DashRobotics/Dash-v1.0/Dash_App/Dash/iphone@2x.png

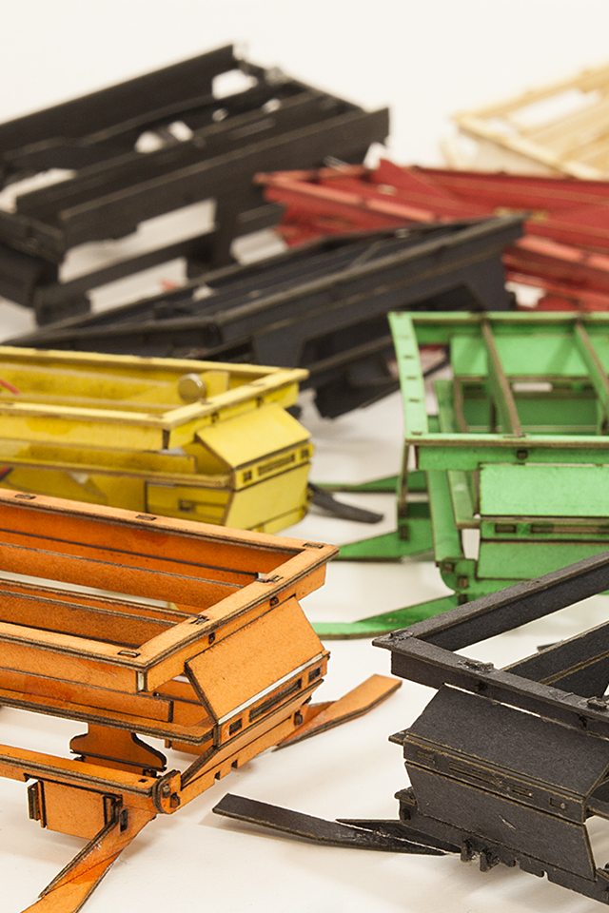
Dash_App/Dash/iphone@2x.png
