DashRobotics/Dash-v1.0/Dashboard-v1.0-hardware/README.md

Dashboard-v1.0
==============

Schematic and PCB files for the Dashboad v1.0

Repository Contents
==============

dashboard_v1_0_schematic.dsn : schematic file, use TinyCAD to read/edit

dashboard_v1_0_schematic.pdf : PDF copy of schematic file

dashboard_v1_0.fpc : PCB files. Use FreePCB to read/edit

/board_renders : .png images of the PCB layers

License Information
==============

The hardware is released under Creative Commons Share-alike 3.0.
