DashRobotics/Dash-v1.0/Examples/README.txt

This repository contains example code for Dash. These will require you to use the Arduino IDE and set up the Dash library.
