DashRobotics/Dash-v1.0/Dash_App/Dash/html/hands_nice_vimeo_small.jpg

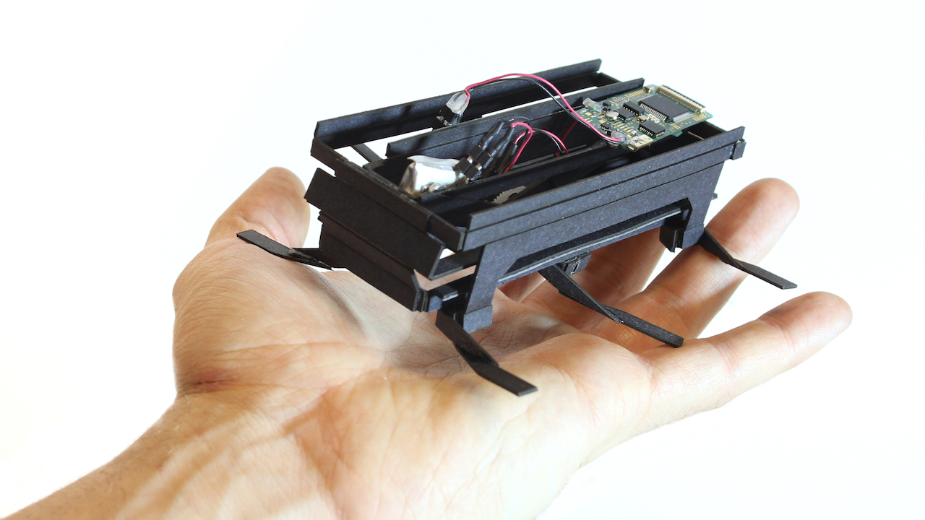
Dash_App/Dash/html/hands_nice_vimeo_small.jpg
