DashRobotics/Dash-v1.0/Dash_App/Dash/iphone-tall-blur@2x.png

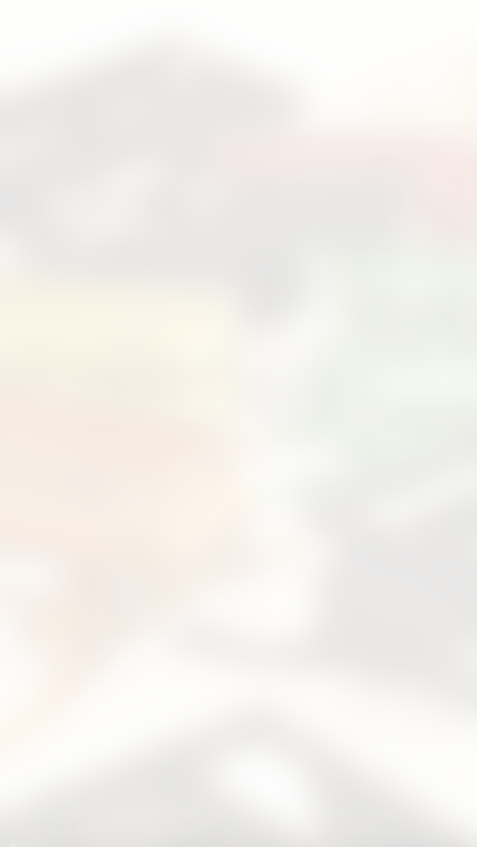
Dash_App/Dash/iphone-tall-blur@2x.png
