DashRobotics/Dash-v1.0/Dash_App/Dash/iphone-tall.png

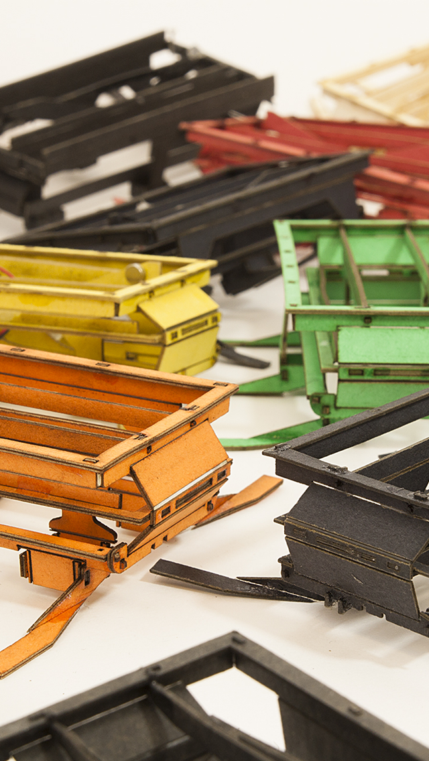
Dash_App/Dash/iphone-tall.png
