DashRobotics/Dash-v1.0/Dashboard-v1.0-hardware/board_renders/board_outline.png

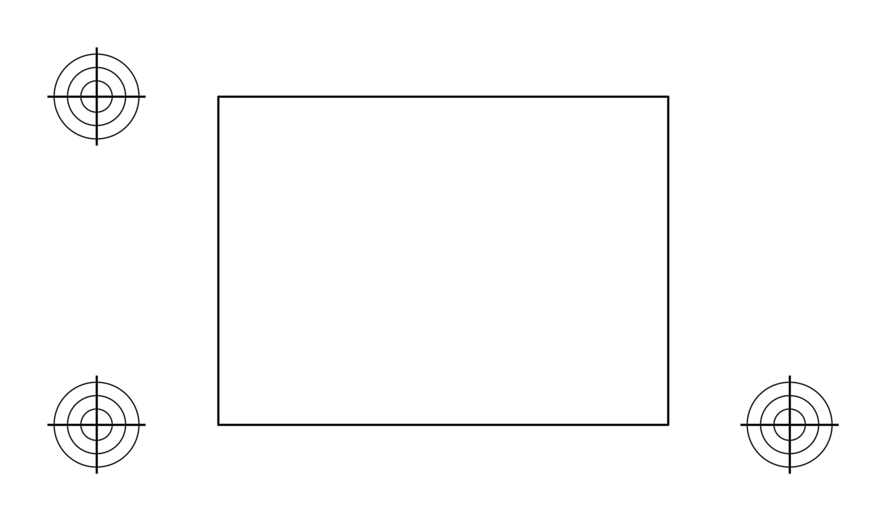
Dashboard-v1.0-hardware/board_renders/board_outline.png
