DashRobotics/Dash-v1.0/Dashboard-v1.0-hardware/board_renders/bottom_copper.png

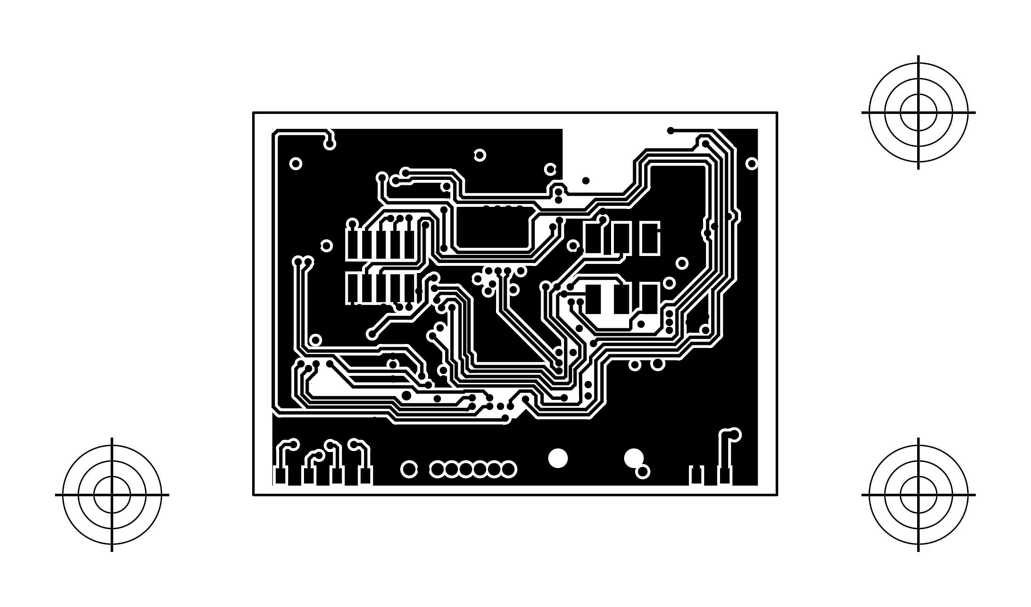
Dashboard-v1.0-hardware/board_renders/bottom_copper.png
