DashRobotics/Dash-v1.0/Dashboard-v1.0-hardware/board_renders/inner_copper_1.png

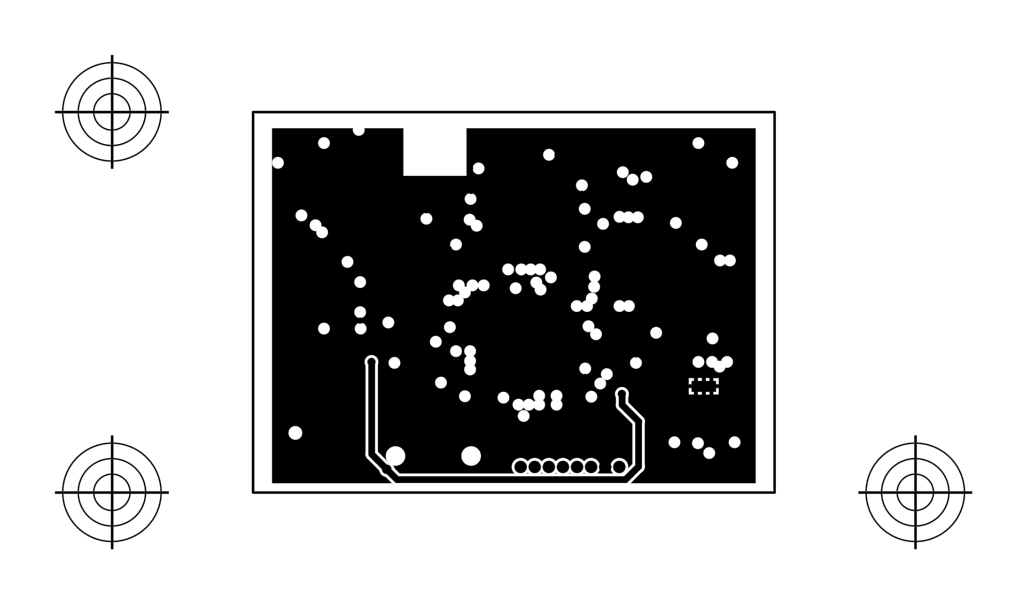
Dashboard-v1.0-hardware/board_renders/inner_copper_1.png
