DashRobotics/Dash-v1.0/Dash_App/Dash/instructions.pdf

## Build instructions

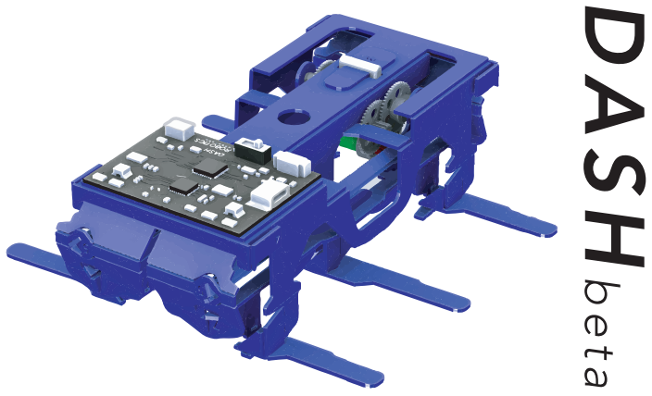
[picture p15: figure]

## Videos and Details at: www.dashrobotics.com, or visit www.forum.dashrobotics.com

Get ready to build your own Dash Robot! The following pages will guide you through the build. A few things to keep in mind while building your robot:

1) Read instructions CAREFULLY!! Orientation of every part matters, take care to align numbers as instructed.
2) Gluing: You will need a small bottle of white glue (like Elmer’s) to get started. Place a small dab of glue where needed, a small drop is enough. After gluing, you must squeeze and hold for 30 seconds.
3) Check Boxes: each step has a check box. Be sure to check the boxes as you go along to ensure you have not missed a step!
4) Handle parts carefully - hold them closely to not bend them.

## Build instructions

# Punch out components

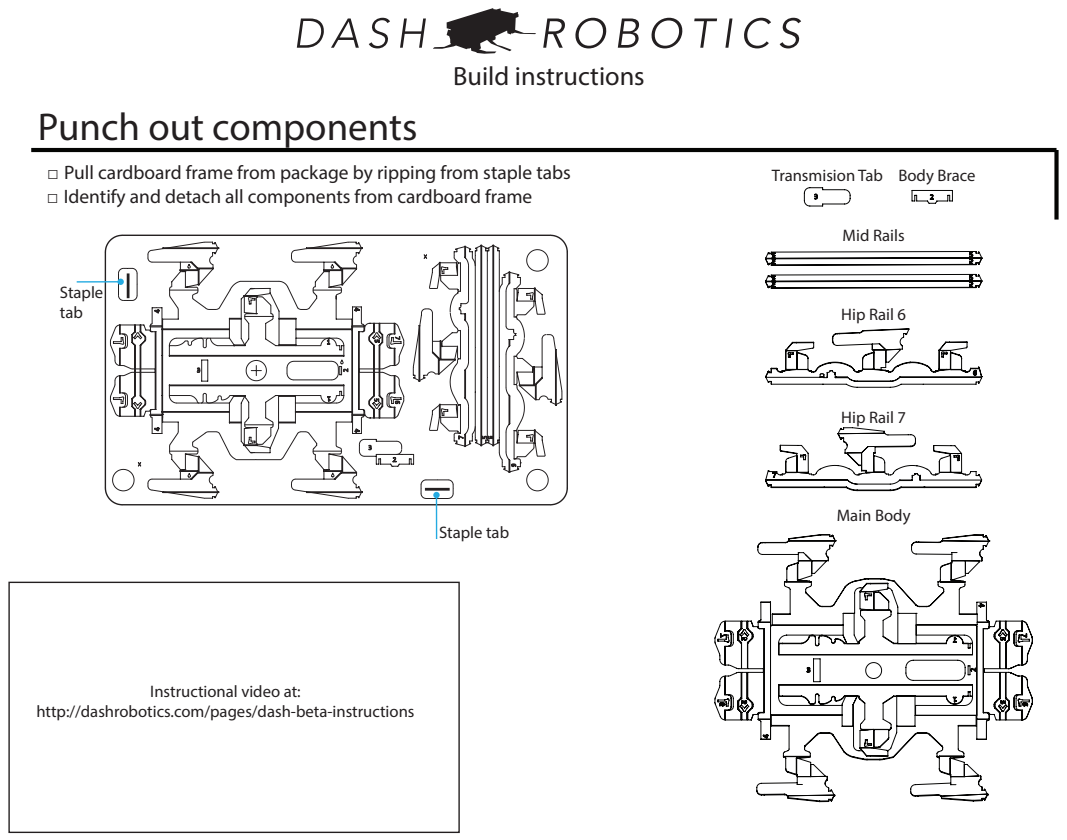
[picture p16: page 2]
Main Body; Hip Rail 6; Hip Rail 7; Mid Rails; □ Pull cardboard frame from package by ripping from staple tabs; Transmision Tab Body Brace; Staple tab

□ Identify and detach all components from cardboard frame

Instructional video at:

http://dashrobotics.com/pages/dash-beta-instructions

## Build instructions

# Fold Legs

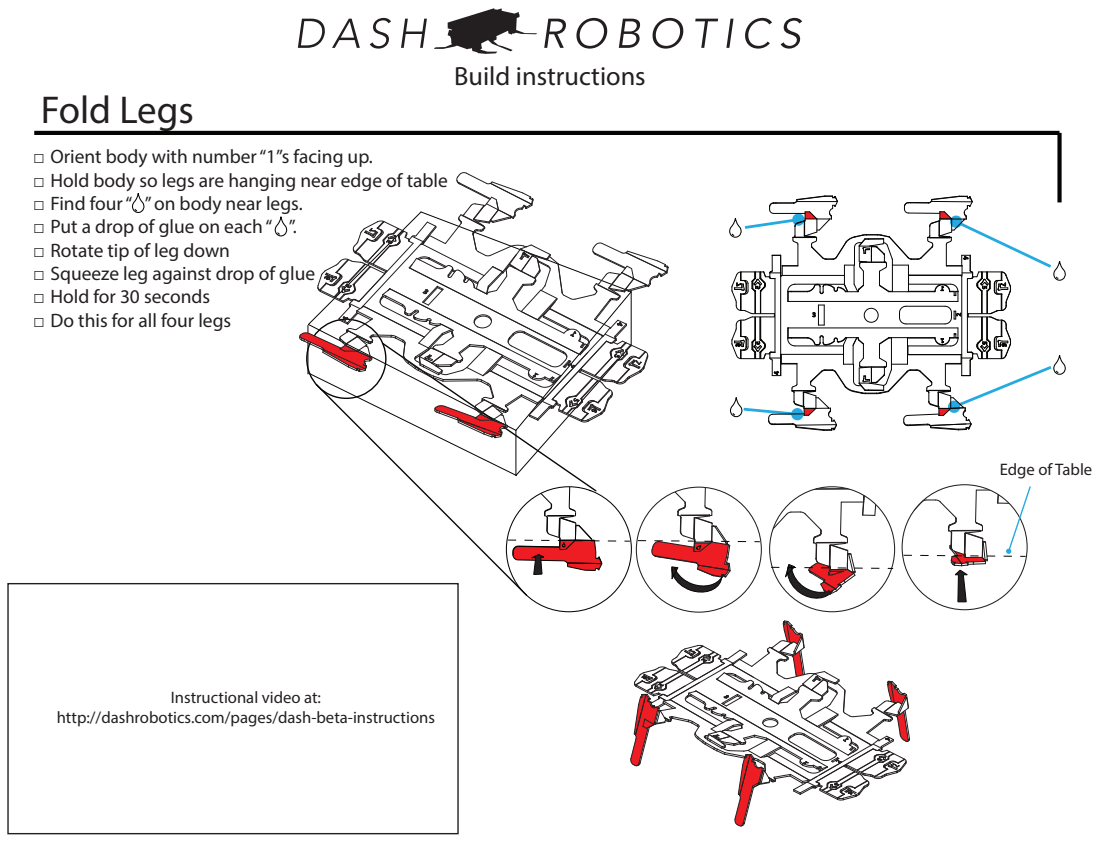
[picture p17: page 3]

□ Orient body with number “1”s facing up.
□ Hold body so legs are hanging near edge of table
□ Find four “ ” on body near legs.
□ Put a drop of glue on each “ ”.
□ Rotate tip of leg down
□ Squeeze leg against drop of glue
□ Hold for 30 seconds
□ Do this for all four legs

Edge of Table

Instructional video at:

http://dashrobotics.com/pages/dash-beta-instructions

## Build instructions

# Insert Body Brace

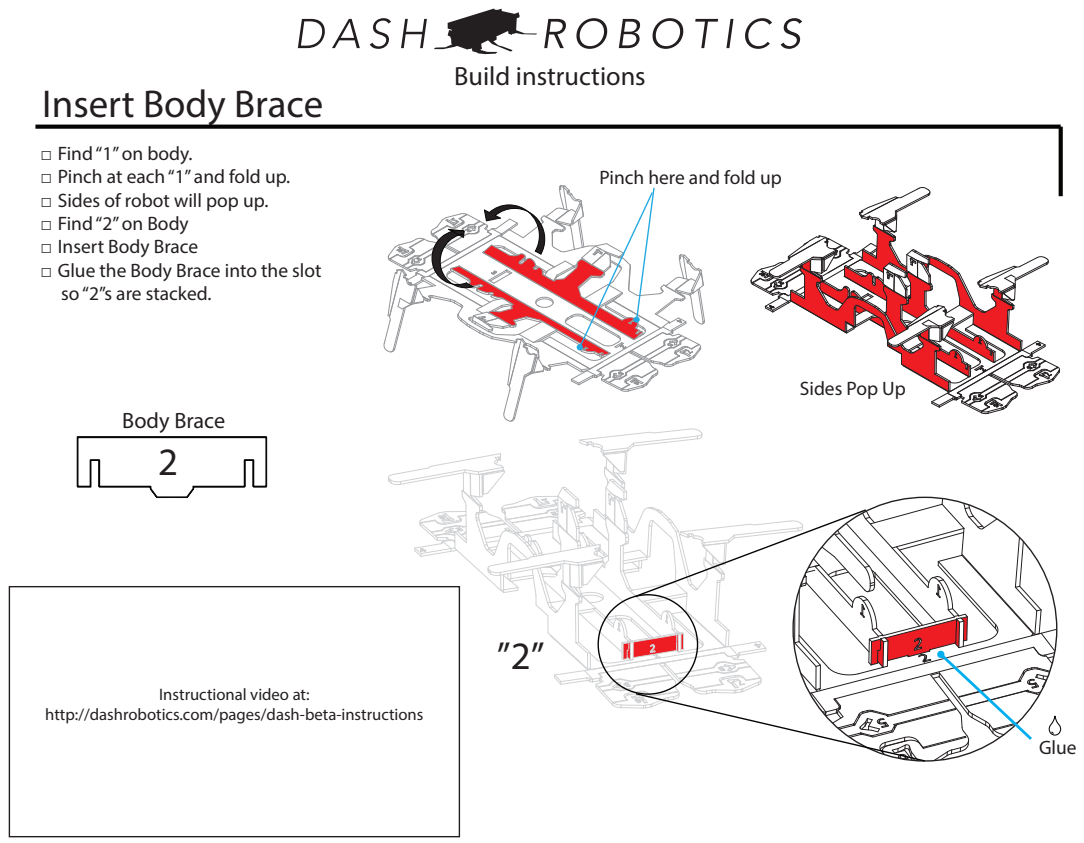
[picture p18: page 4]
Body Brace 2; Glue

□ Find “1” on body.
□ Pinch at each “1” and fold up.
□ Sides of robot will pop up.
□ Find “2” on Body
□ Insert Body Brace
□ Glue the Body Brace into the slot
so “2”s are stacked.

Pinch here and fold up

Sides Pop Up

Instructional video at:

http://dashrobotics.com/pages/dash-beta-instructions

## Build instructions

# Insert Transmission

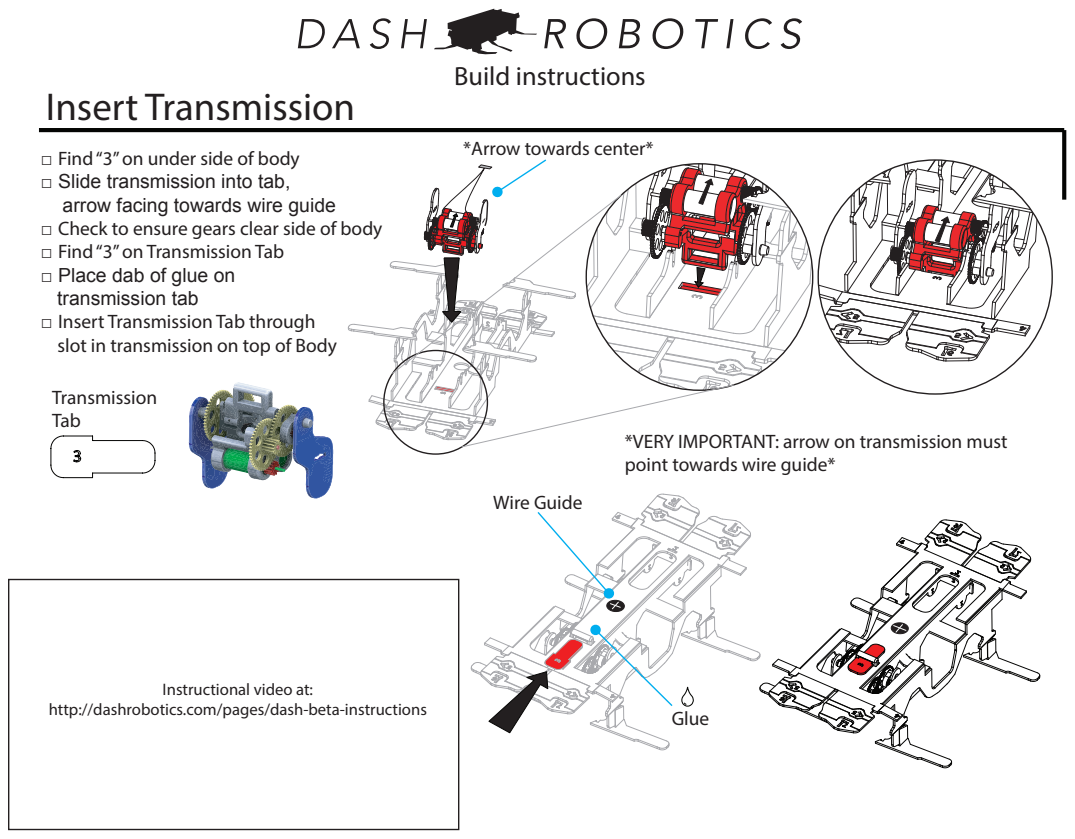
[picture p19: page 5]
Glue; Wire Guide; Transmission Tab

*Arrow towards center*

□ Find “3” on under side of body
□ Slide transmission into tab,
arrow facing towards wire guide
□ Check to ensure gears clear side of body
□ Find “3” on Transmission Tab
□ Place dab of glue on
transmission tab
□ Insert Transmission Tab through
slot in transmission on top of Body

*VERY IMPORTANT: arrow on transmission must
point towards wire guide*

Instructional video at:

http://dashrobotics.com/pages/dash-beta-instructions

## Build instructions

# Fold & Glue Front & Rear

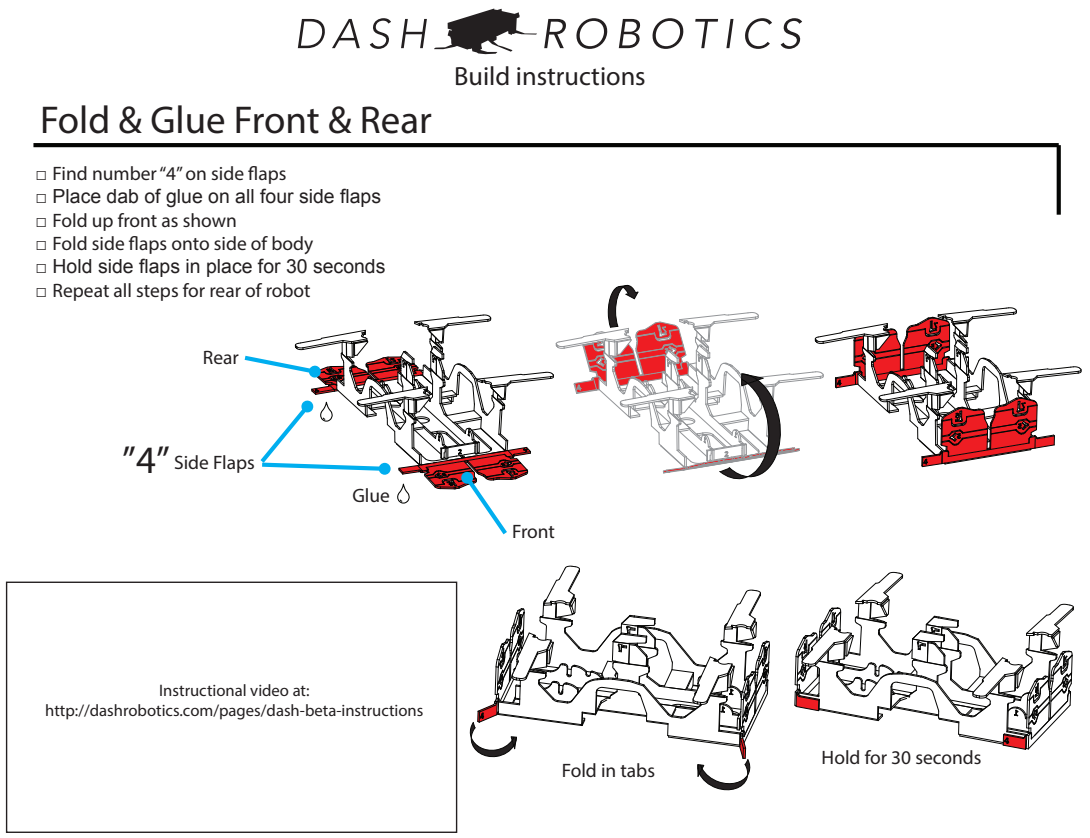
[picture p20: page 6]
Front; Side Flaps; Rear; Glue

□ Find number “4” on side aps
□ Place dab of glue on all four side flaps
□ Fold up front as shown
□ Fold side aps onto side of body
□ Hold side flaps in place for 30 seconds
□ Repeat all steps for rear of robot

Instructional video at:

http://dashrobotics.com/pages/dash-beta-instructions

Hold for 30 seconds

Fold in tabs

## Build instructions

”5”

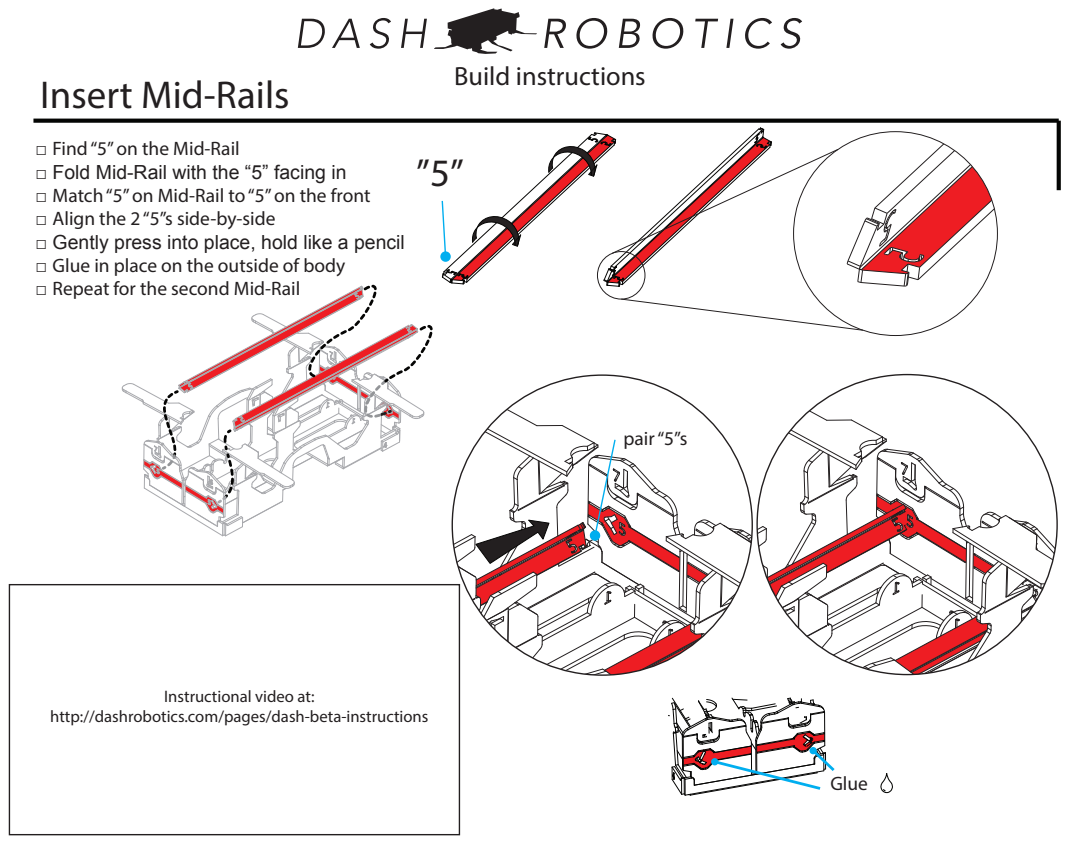
[picture p21: page 7]
Glue; pair “5”s

Insert Mid-Rails

□ Find “5” on the Mid-Rail
□ Fold Mid-Rail with the “5” facing in
□ Match “5” on Mid-Rail to “5” on the front
□ Align the 2 “5”s side-by-side
□ Gently press into place, hold like a pencil
□ Glue in place on the outside of body
□ Repeat for the second Mid-Rail

Instructional video at:

http://dashrobotics.com/pages/dash-beta-instructions

## Build instructions

# Insert Hip Rail #6

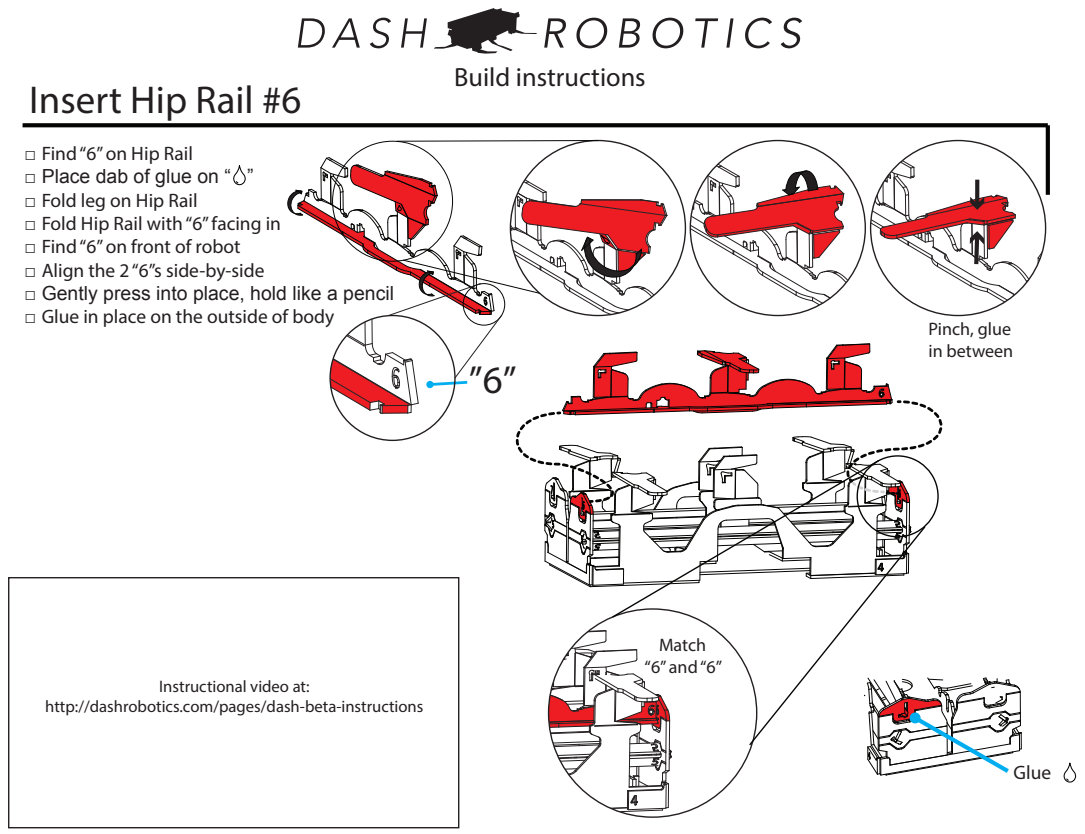
[picture p22: page 8]
Match “6” and “6”; Pinch, glue in between; Glue

□ Find “6” on Hip Rail
□ Place dab of glue on “ ”
□ Fold leg on Hip Rail
□ Fold Hip Rail with “6” facing in
□ Find “6” on front of robot
□ Align the 2 “6”s side-by-side
□ Gently press into place, hold like a pencil
□ Glue in place on the outside of body

Instructional video at:

http://dashrobotics.com/pages/dash-beta-instructions

## Build instructions

# Insert Hip Rail #7

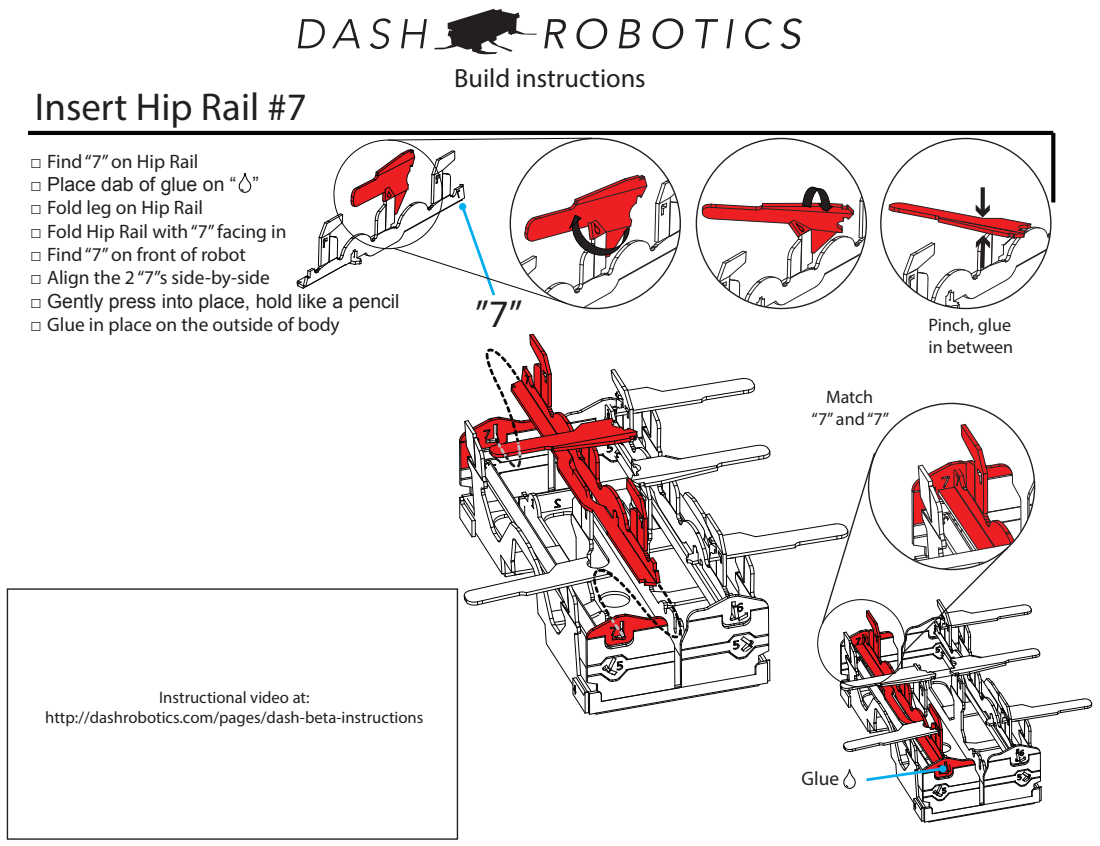
[picture p23: page 9]
Match “7” and “7”; Pinch, glue in between; Glue

□ Find “7” on Hip Rail
□ Place dab of glue on “ ”
□ Fold leg on Hip Rail
□ Fold Hip Rail with “7” facing in
□ Find “7” on front of robot
□ Align the 2 “7”s side-by-side
□ Gently press into place, hold like a pencil
□ Glue in place on the outside of body

Instructional video at:

http://dashrobotics.com/pages/dash-beta-instructions

## Build instructions

# Fold 6 Leg Flaps

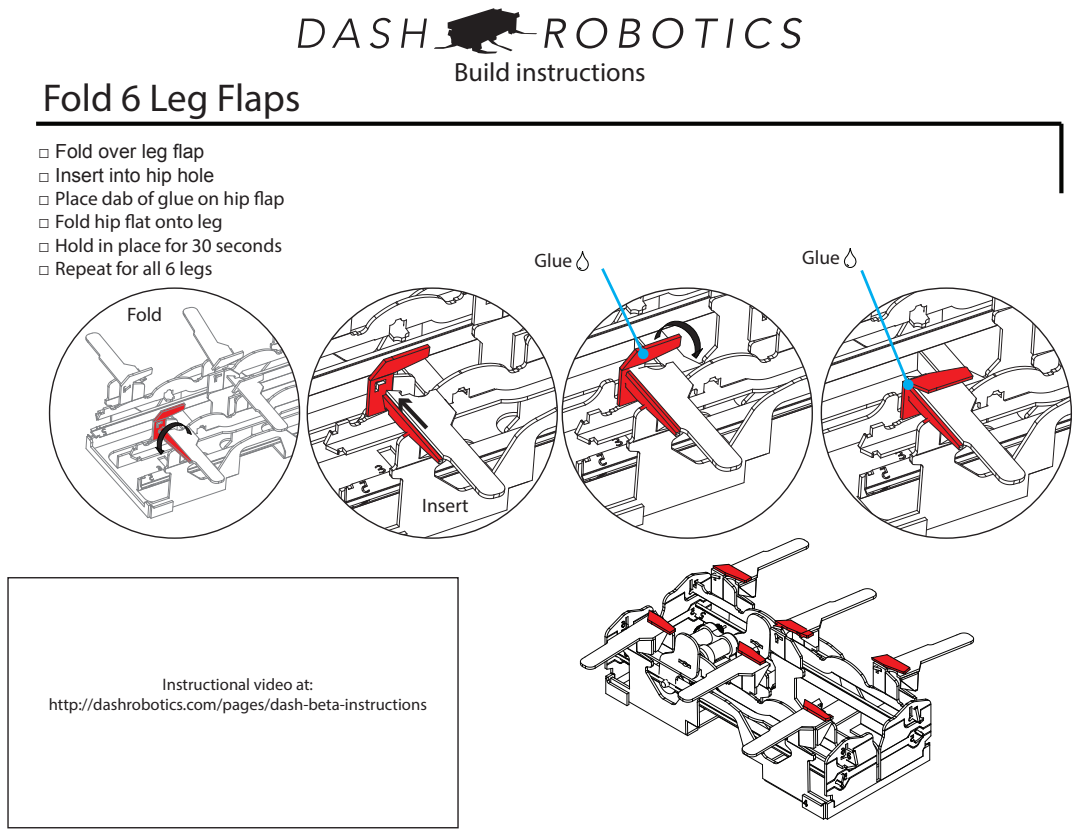
[picture p24: page 10]
□ Repeat for all 6 legs; Glue; Insert; Fold

□ Fold over leg flap
□ Insert into hip hole
□ Place dab of glue on hip ap
□ Fold hip at onto leg
□ Hold in place for 30 seconds

Instructional video at:

http://dashrobotics.com/pages/dash-beta-instructions

## Build instructions

# Transmission Outputs

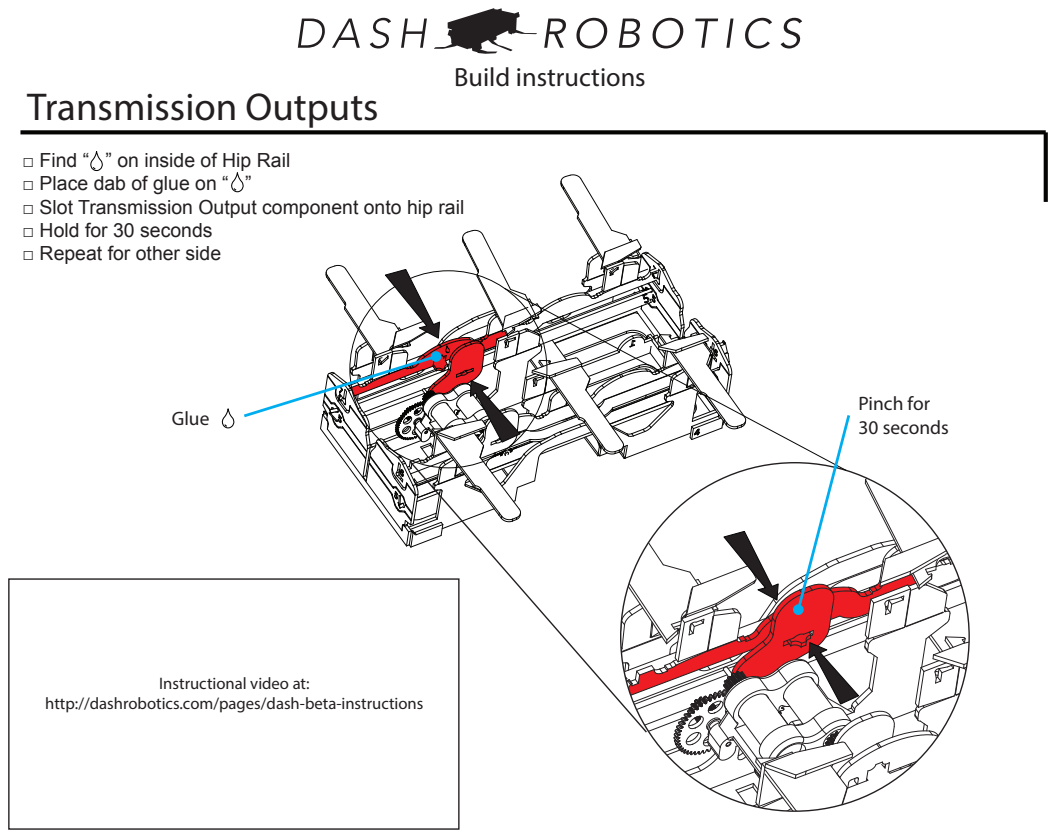
[picture p25: page 11]
Glue; Pinch for 30 seconds

□ Find “ ” on inside of Hip Rail
□ Place dab of glue on “ ”
□ Slot Transmission Output component onto hip rail
□ Hold for 30 seconds
□ Repeat for other side

Instructional video at:

http://dashrobotics.com/pages/dash-beta-instructions

## Build instructions

# Attach DashBoard

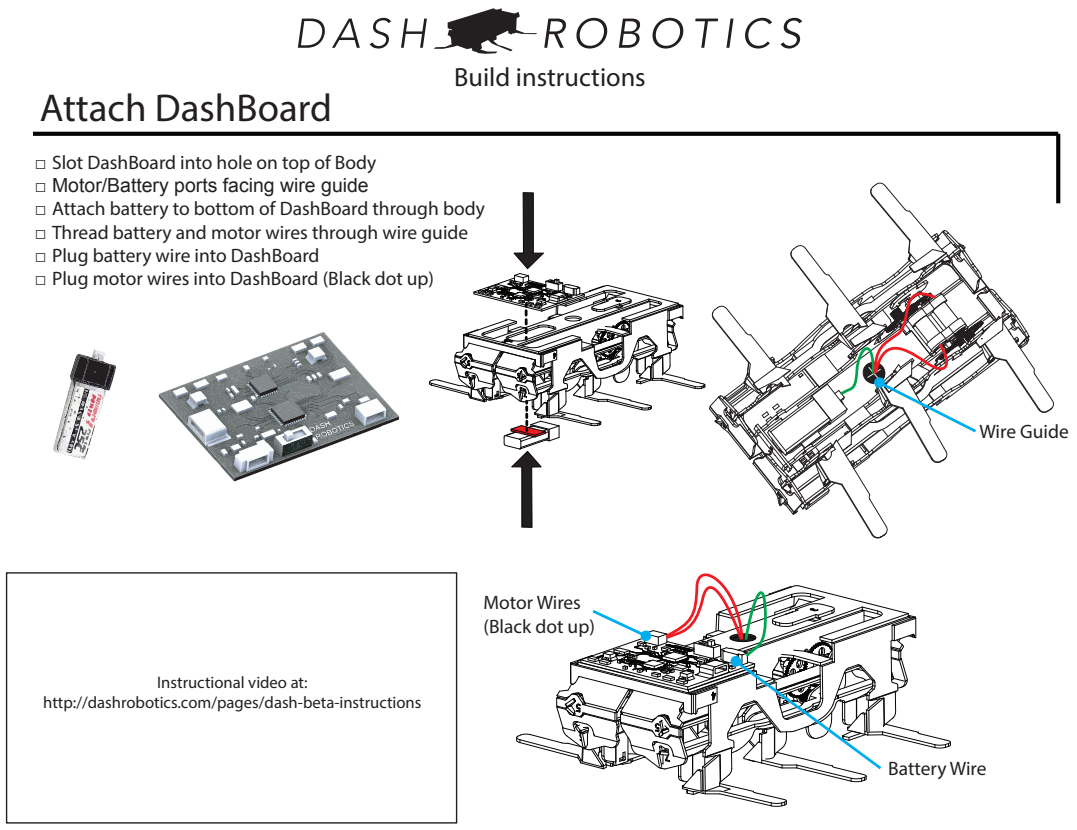
[picture p26: page 12]
Wire Guide; Battery Wire

□ Slot DashBoard into hole on top of Body
□ Motor/Battery ports facing wire guide
□ Attach battery to bottom of DashBoard through body
□ Thread battery and motor wires through wire guide
□ Plug battery wire into DashBoard
□ Plug motor wires into DashBoard (Black dot up)

Motor Wires
(Black dot up)

Instructional video at:

http://dashrobotics.com/pages/dash-beta-instructions
