DashRobotics/Dash-v1.0/Dash_App/Dash/Instruction Images/Instructional_html/about.html

Dash is the world's first lightning-fast origami robot that you can build yourself. His animal-inspired design allows for a fun, high performance robot at a price never before possible.

Learn more and order yours today at DashRobotics.com!

Send Feedback Write a Review (http://itunes.apple.com/app/id875667450)

DashDrive 1.0 (build 33)
