DashRobotics/Dash-v1.0/Dash_App/Dash/Instruction Images/Intro.png

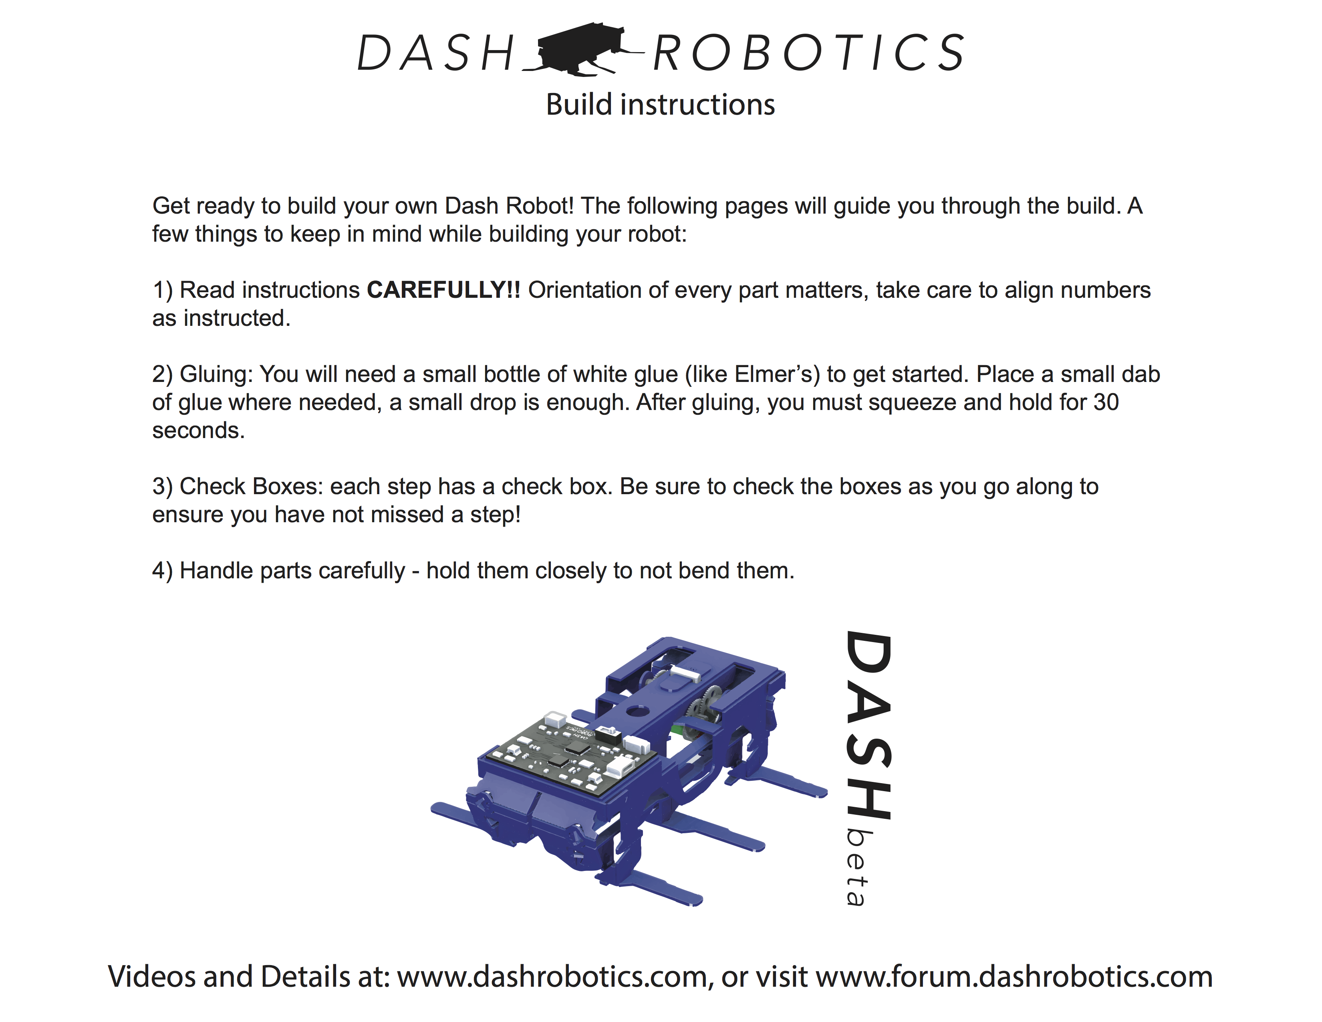
Dash_App/Dash/Instruction Images/Intro.png
