DashRobotics/Dash-v1.0/Dash_App/Dash/Instruction Images/Step6.png

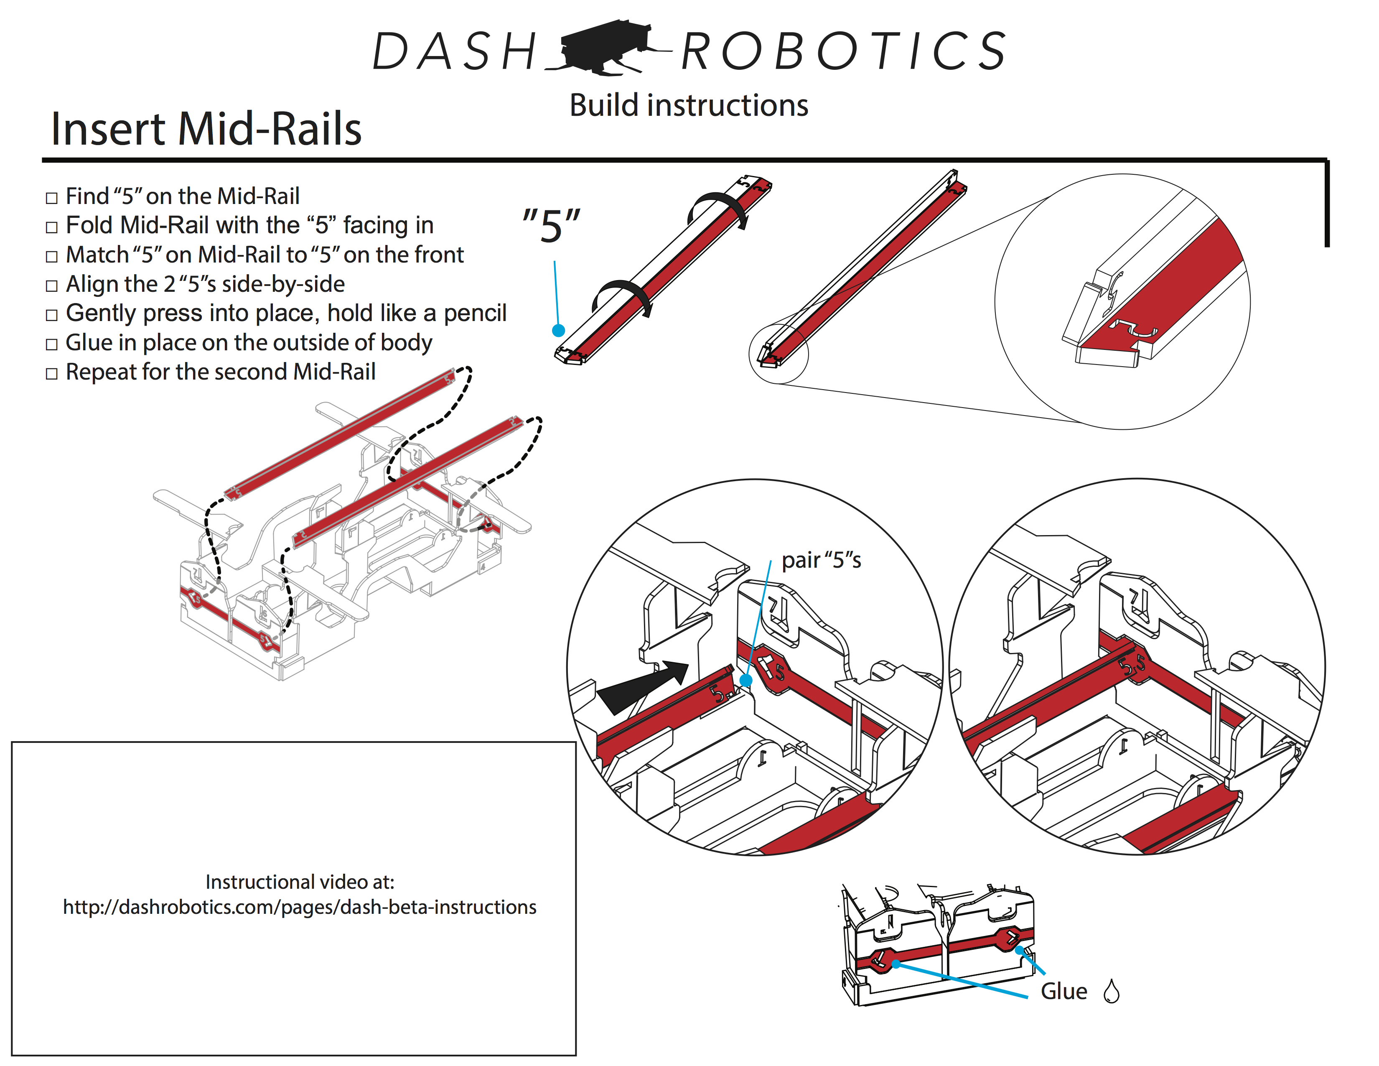
Dash_App/Dash/Instruction Images/Step6.png
