DashRobotics/Dash-v1.0/Dash_App/Dash/Instruction Images/Step7.png

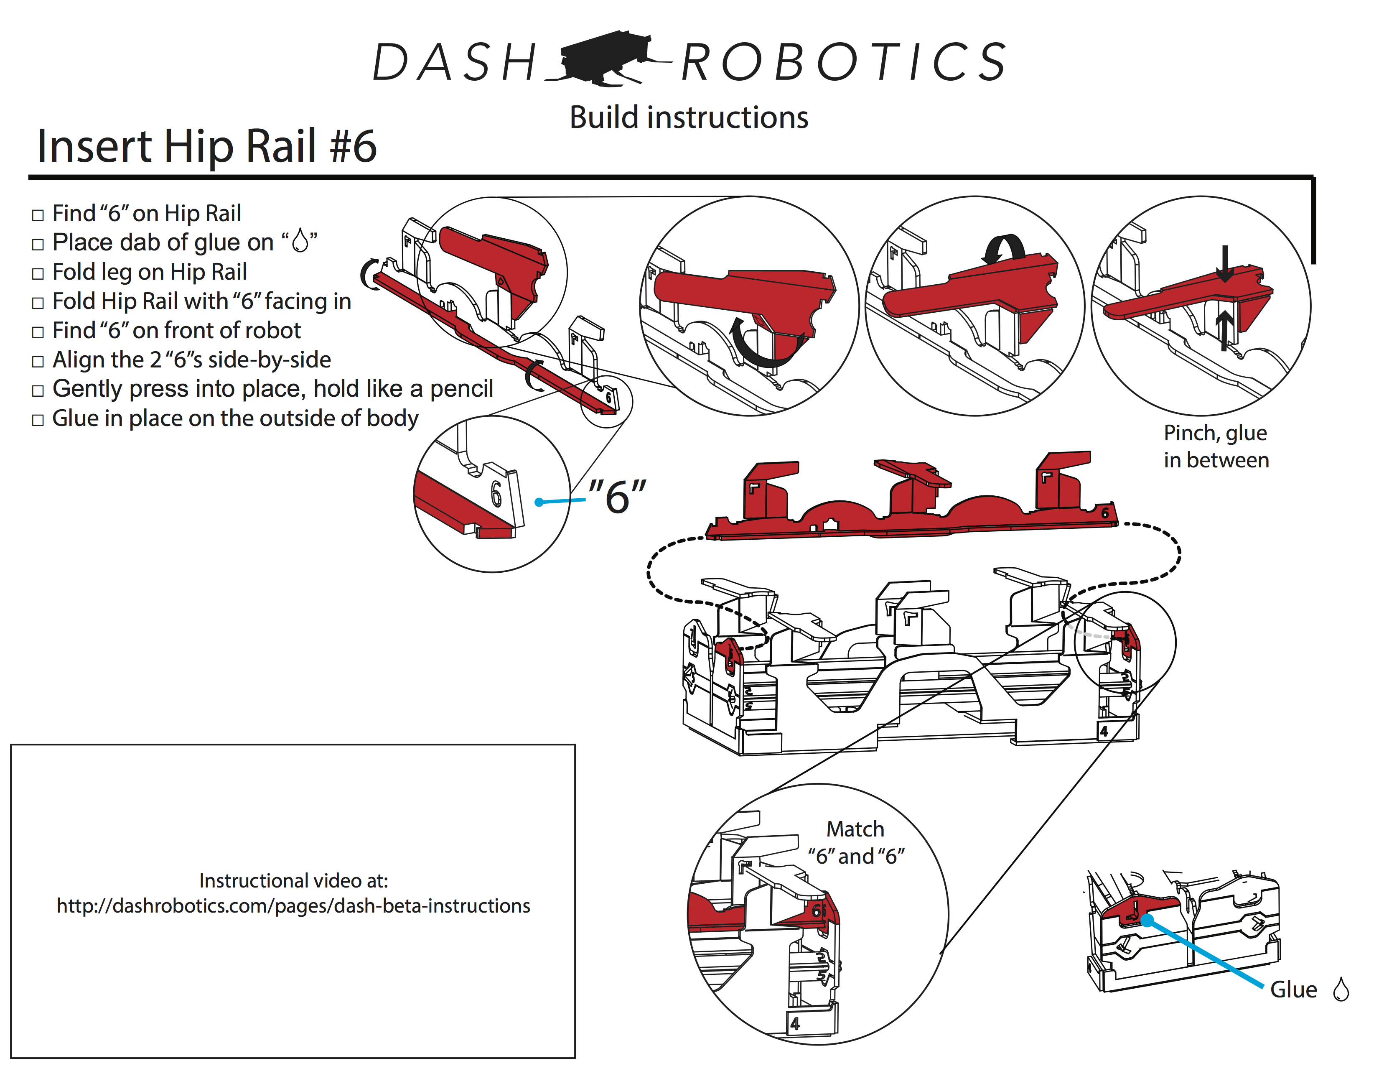
Dash_App/Dash/Instruction Images/Step7.png
