DashRobotics/Dash-v1.0/Dashboard-v1.0-hardware/dashboard_v1_0_schematic.pdf

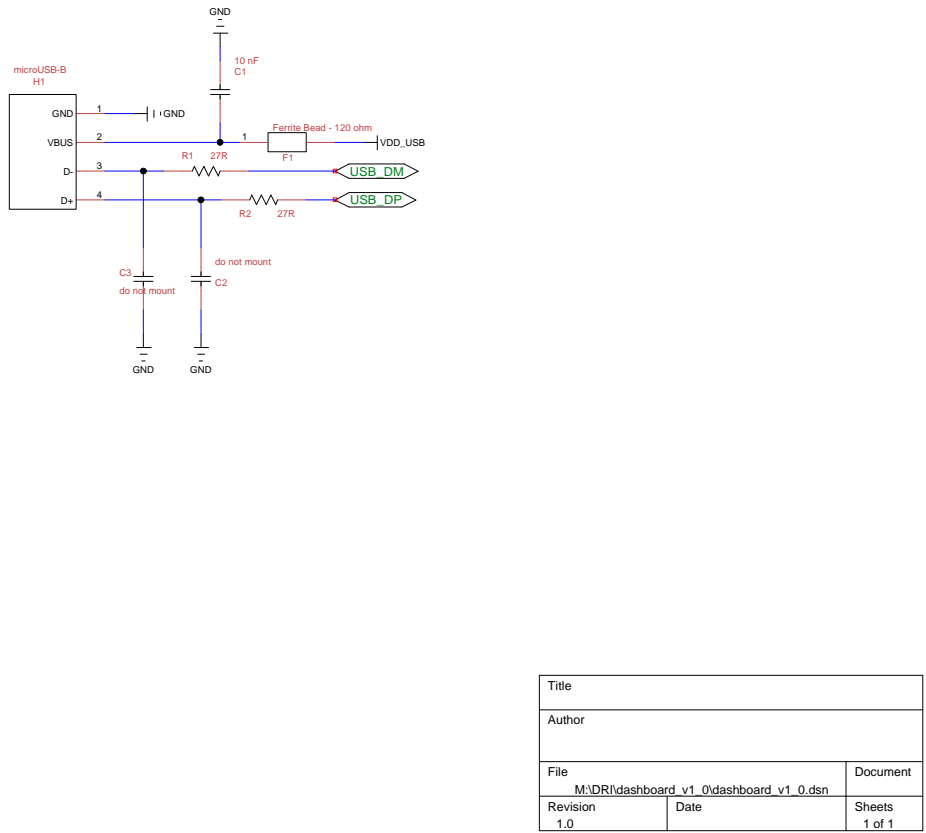
[picture p33: page 1]
GND; VBUS; microUSB-B; USB_DP; USB_DM; Title; Author

Ferrite Bead - 120 ohm
VDD_USB 1

do not mount

File M:\DRI\dashboard_v1_0\dashboard_v1_0.dsn | Document

Revision 1.0 | Date | Sheets 1 of 1

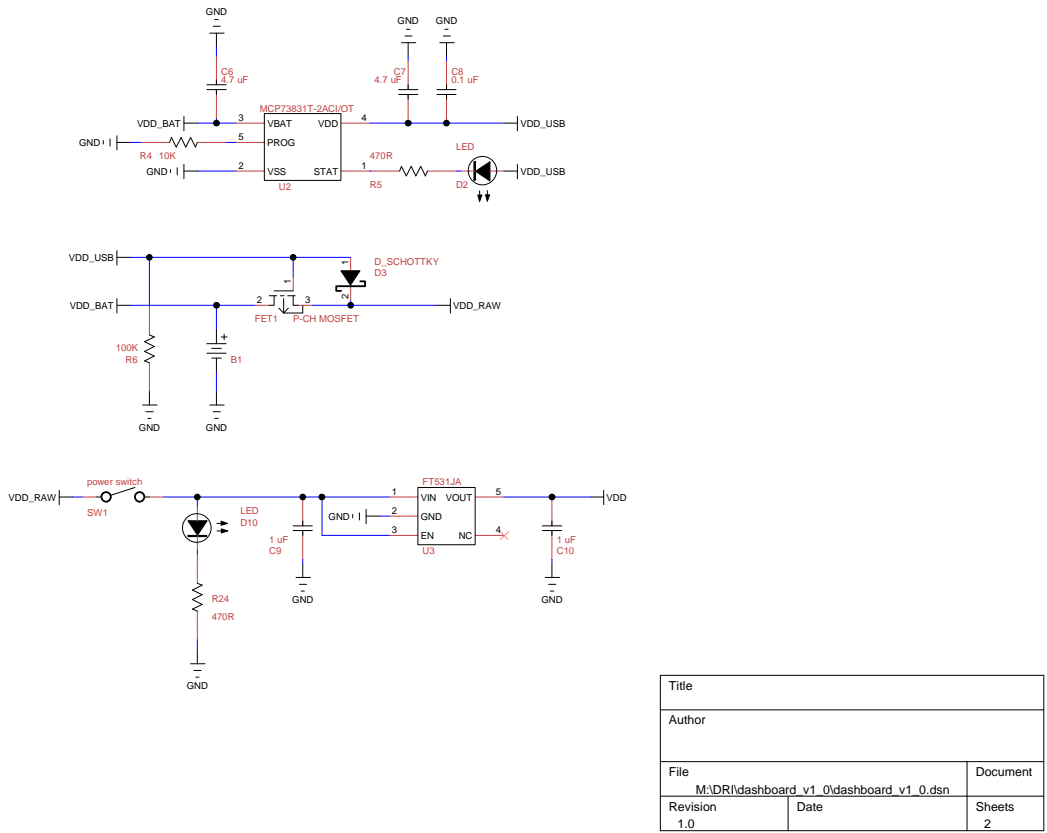
[picture p34: page 2]

## gyr_AREF

## gyr_OUT

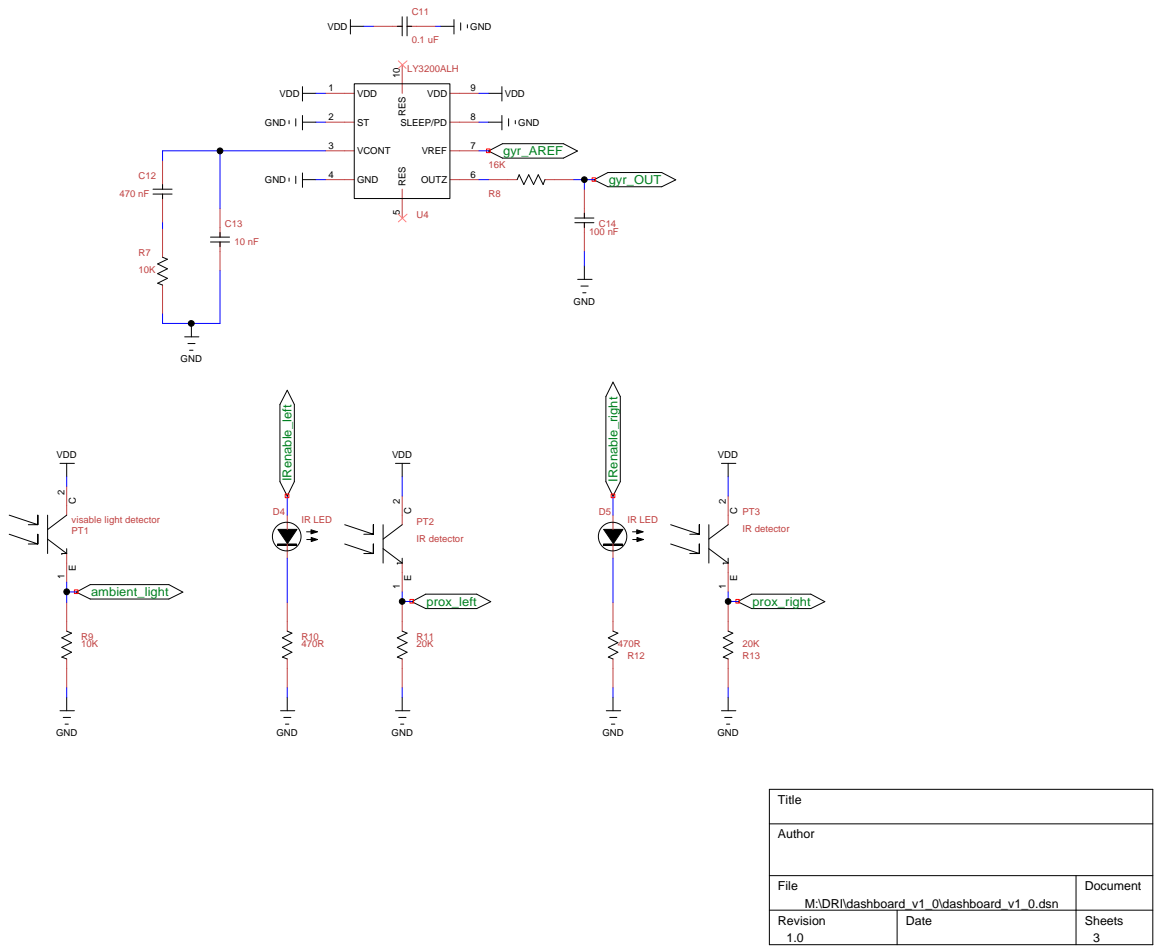
[picture p35: page 3]

## radio_WAKEUP

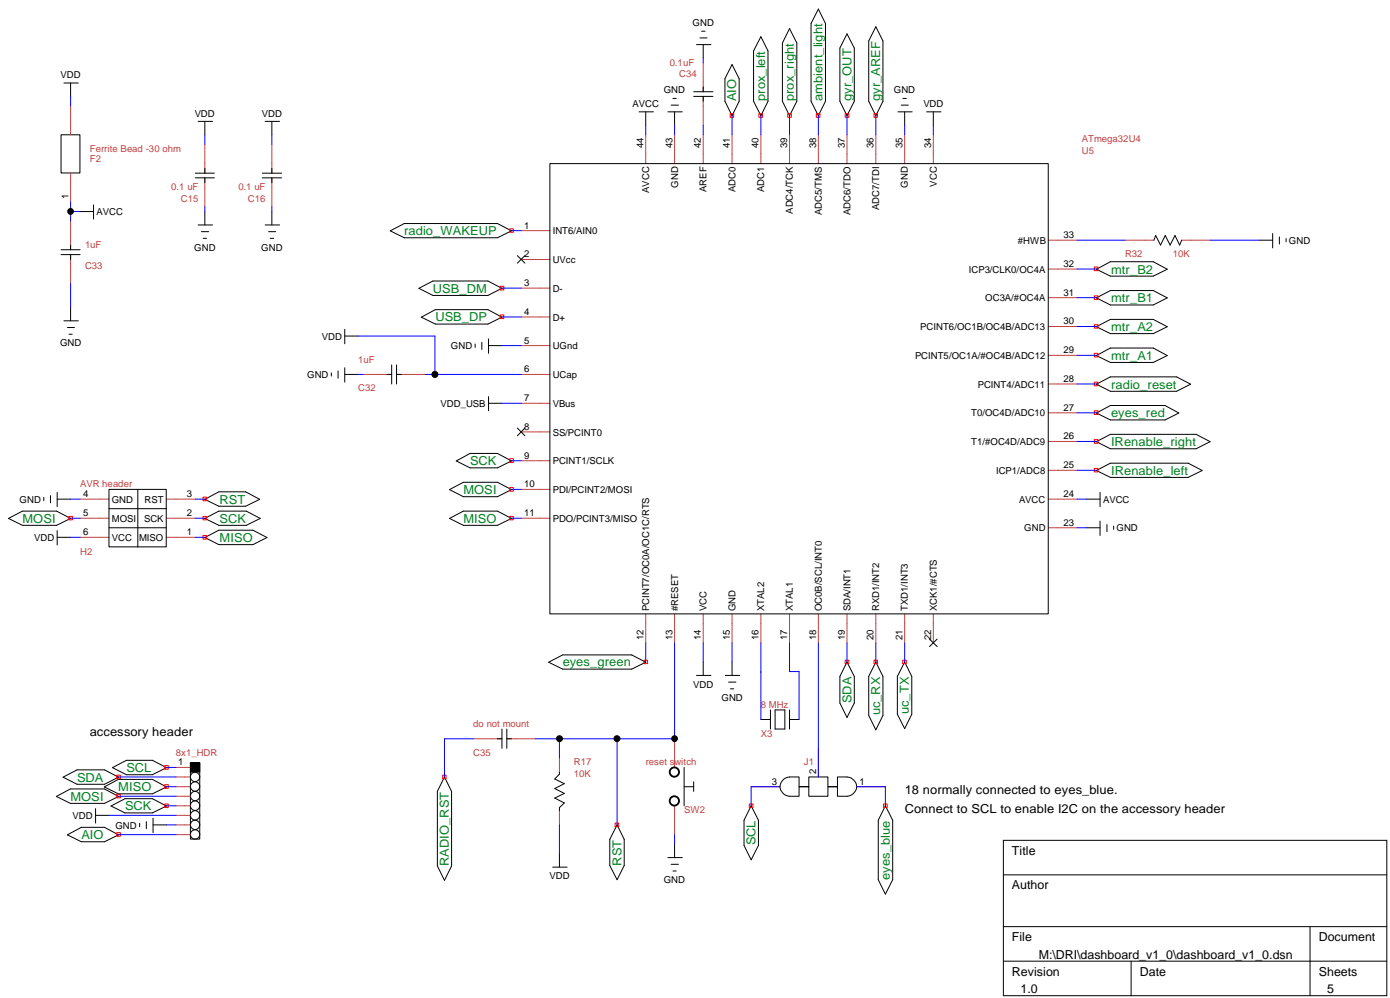
[picture p36: page 4]

Connect to SCL to enable I2C on the accessory header

## DC/P2_2 SSN/P0_4

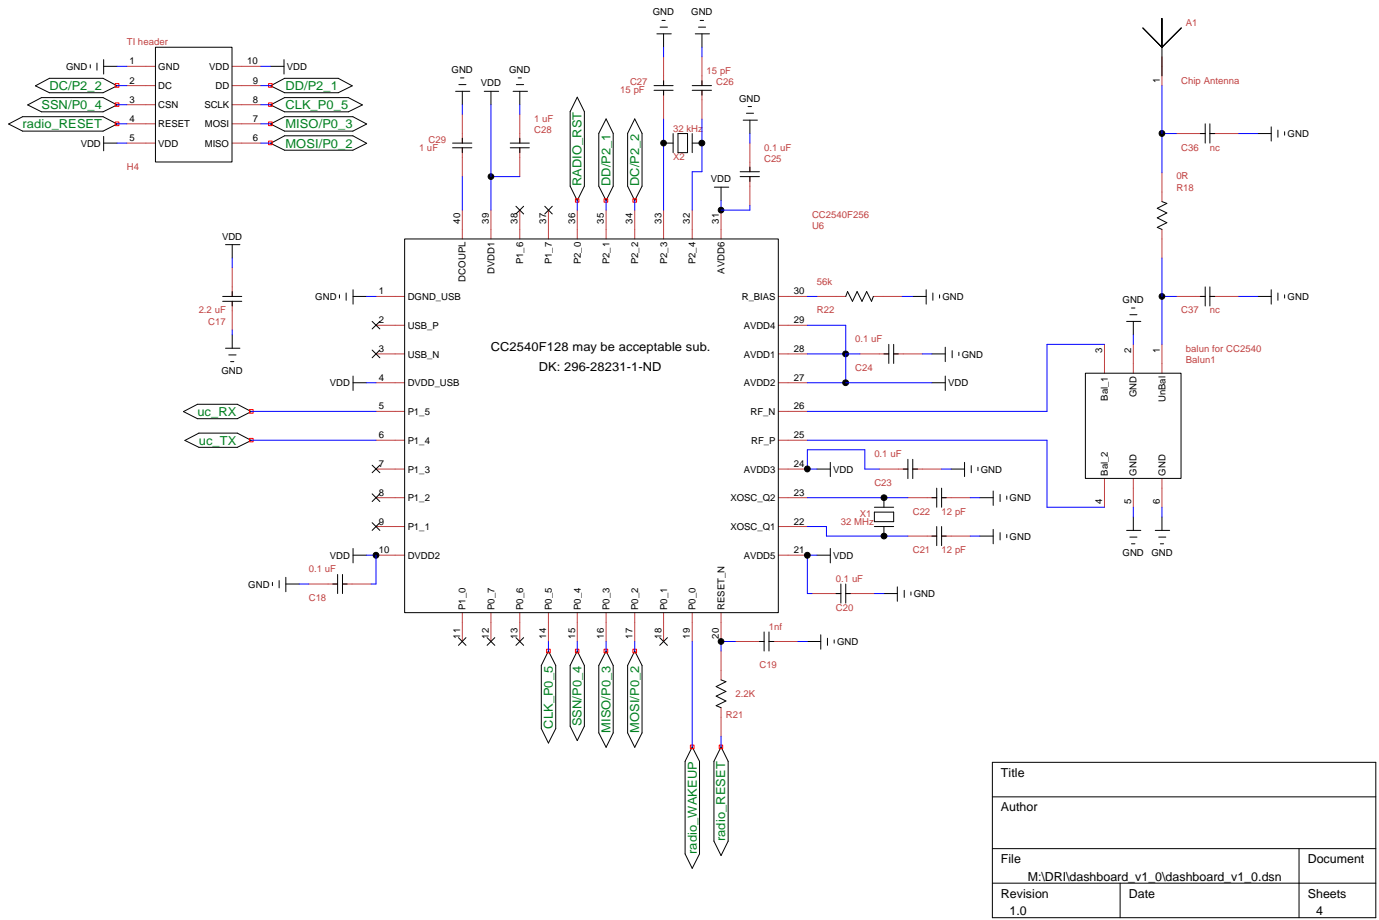
[picture p37: page 5]

CC2540F128 may be acceptable sub.

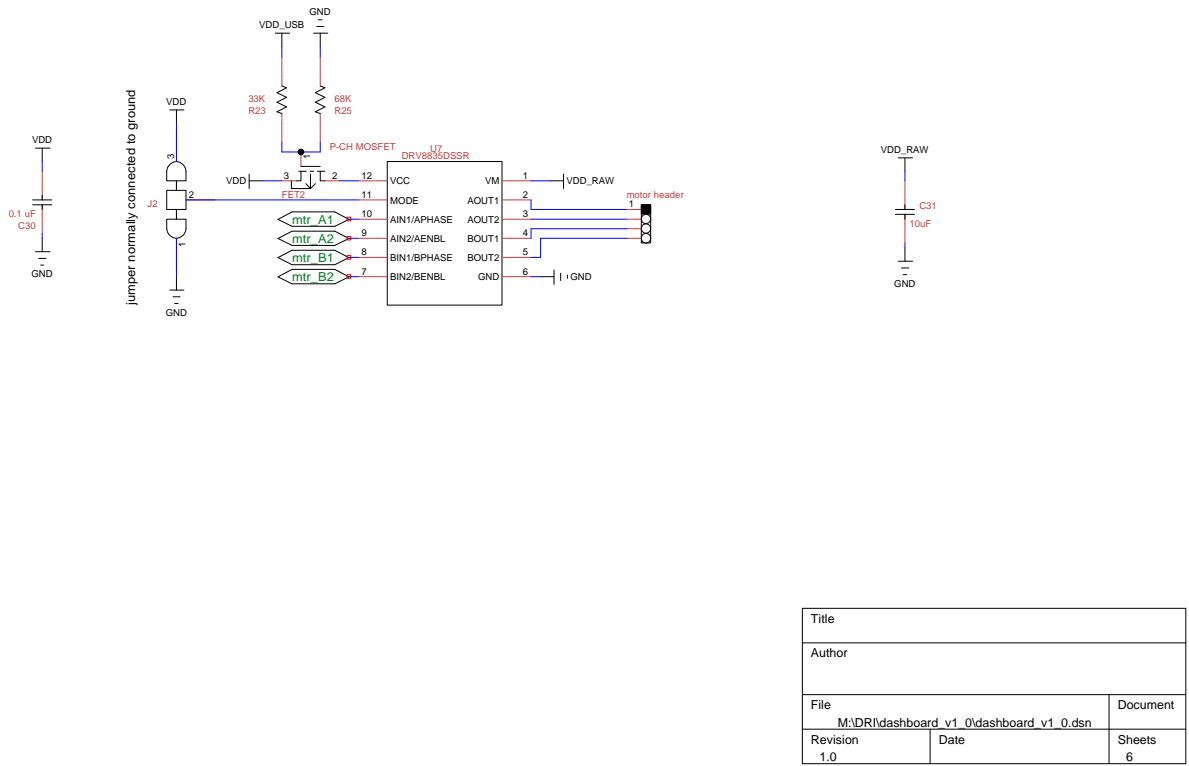
[picture p38: page 6]
AOUT1; AOUT2; BOUT1; BOUT2; GND; VCC 12; MODE 11; AIN1/APHASE 10; AIN2/AENBL; BIN1/BPHASE; BIN2/BENBL; U7 DRV8835DSSR; VDD; VDD_RAW; mtr_A1 mtr_A2 mtr_B1; mtr_B2; FET2; P-CH MOSFET; VDD_USB; motor header; Title; Author

jumper normally connected to ground

## Eyes

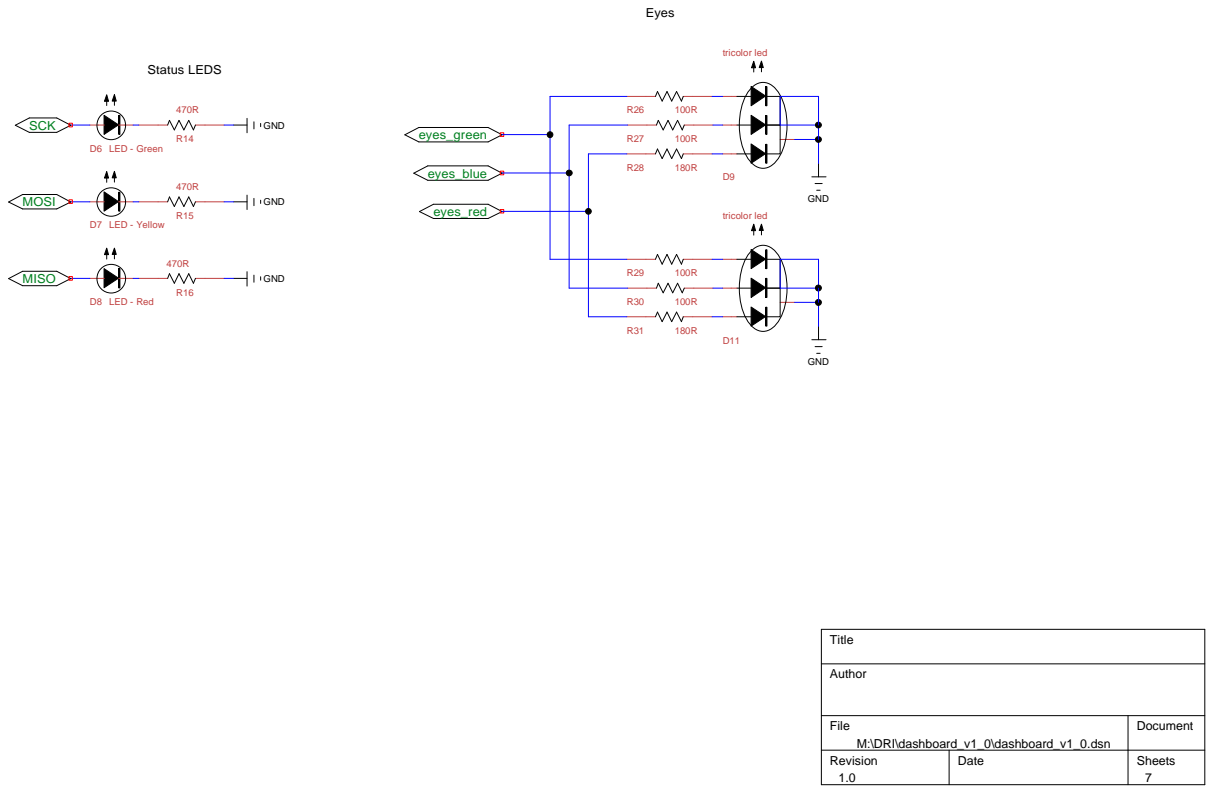
[picture p39: page 7]
