DashRobotics/Dash-v1.0/(list of files, drawings)

Other design files:
Dashboard-v1.0-hardware/dashboard_v1_0_schematic.dsn
